omidyaghmazadeh/3D_Print_Designs/3D_Print_Platform_for_In_Vivo_MRI_in_Mice_and_Rats/Readme.md

This is an open-source versatile animal conditioning set-up for MRI (an other imaging) experiments on mice and rats. 
The design is made in a collaborative effort between the Buzsaki Lab (Neuroscience Institute), the Alon Lab (Radiology Dep.), and the Preclinical Imaging Lab (Radiology Dep.) at the NYU Langone Medical Center.

RodentMRI_bed

Parts with finer dimensions are optimized for Form 2 printer from Formlab. Adjustments might be needed for other printers.
The stand.stl and walls.stl might be printed by most printers without issue.

The complete and easy-to-modify design (developed using Autodesk Fusion 360) is available at: https://a360.co/3u0Dsnh. 

For any questions or concerns please contact omid.yaghmazadeh@gmail.com

The headfixation mechanism was modified based on Mihaly Voroslakos' design available at:
https://github.com/misiVoroslakos/3D_printed_designs/tree/main/mouse_treadmill_RF.

This design is distributed under the GNU GPLv3 license.

--> If you use our design, please cite our paper:
Ben Youss, Z., Arefin, T.M., et al. Open-source versatile 3D-print animal conditioning platform design for in vivo preclinical brain imaging in awake mice and anesthetized mice and rats. Lab Anim 53, 33–42 (2024). https://doi.org/10.1038/s41684-023-01320-z

We have also developed a cooling/heating system that is compatible with this design and open-source. If interested, please see the following paper: Verghese G, et al. Autonomous animal heating and cooling system for temperature-regulated magnetic resonance experiments. NMR in Biomedicine. 2024; 37(2):e5046. doi:10.1002/nbm.5046
