omidyaghmazadeh/3D_Print_Designs/ProbeParking/Readme.md

This is a holder with 10 spots with a similar diameter (at the central height) as the electrode holder rod of the Kopf stereotaxic system. It is the parking lot for your used silicon probes or other implants.

Holder_Station_Base v10

Design by Omid Yaghmazadeh - 2022
