omidyaghmazadeh/3D_Print_Designs/Mouse_HeadFixation_SetUp/Readme.md

This is a headfixation set-up for neuroscience experiments on mice. 
The head-cap is designed to provide a large surface on the skull for implanting probes, fibers, etc.

HeadFixed_Miniscope v9

Parts with finer dimensions are optimized for Form 2 printer from Formlab. Adjustment might be needed for other printers.
The stand.stl and walls.stl might be printed by most printers without issue.

This headfixation system was modified based on Mihaly Voroslakos' design available at:
https://github.com/misiVoroslakos/3D_printed_designs/tree/main/mouse_treadmill_RF.

This design is distributed under GNU GPLv3 license.
