omidyaghmazadeh/3D_Print_Designs/3D_Print_Platform_for_In_Vivo_MRI_in_Mice_and_Rats/Base_Joint1.stl

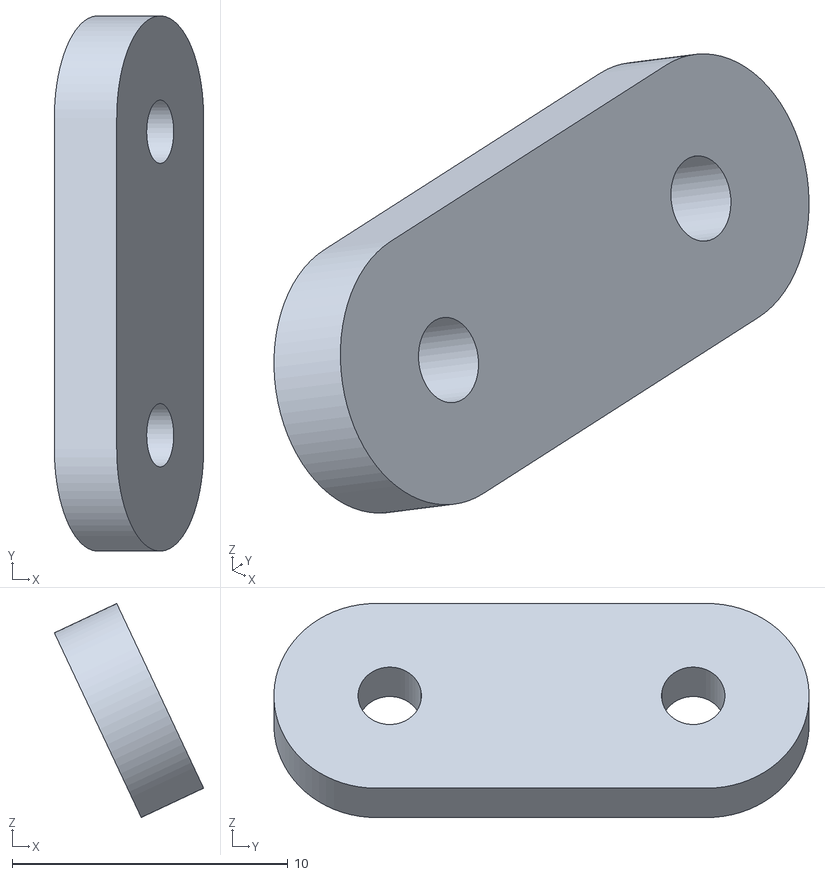
[picture p1: CAD file, 2022-05-18]
3D_Print_Platform_for_In_Vivo_MRI_in_Mice_and_Rats/Base_Joint1.stl
5.41 x 19.4 x 7.76
