omidyaghmazadeh/3D_Print_Designs/Mouse_HeadFixation_SetUp/StandHolder1.stl

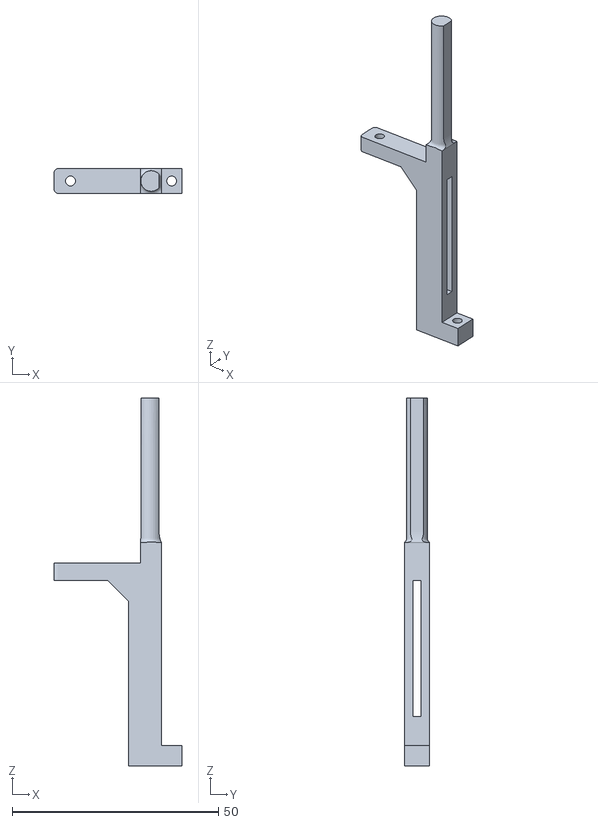
[picture p2: CAD file, 2022-04-08]
Mouse_HeadFixation_SetUp/StandHolder1.stl
31.0 x 6.04 x 89.2
