omidyaghmazadeh/3D_Print_Designs/ProbeParking/BaseFor10ProbeHolders_NarrowerTop.stl

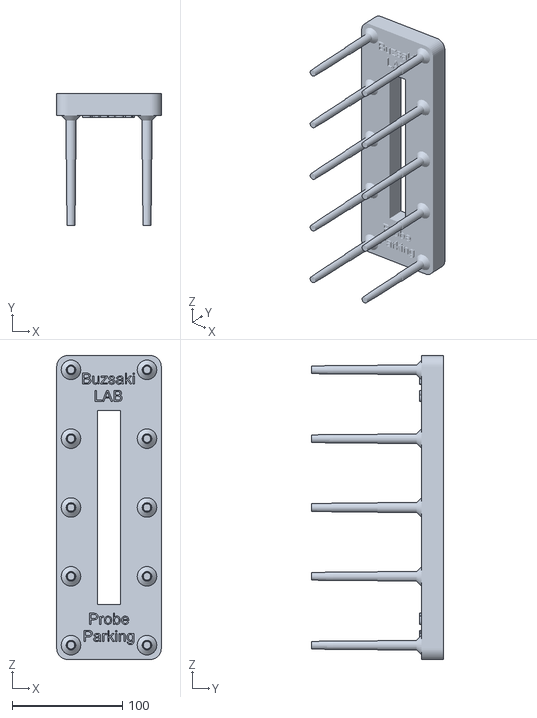
[picture p3: CAD file, 2022-10-27]
ProbeParking/BaseFor10ProbeHolders_NarrowerTop.stl
95.0 x 120.0 x 276.0
