omidyaghmazadeh/3D_Print_Designs/3D_Print_Platform_for_In_Vivo_MRI_in_Mice_and_Rats/HeadFixClamp2.stl

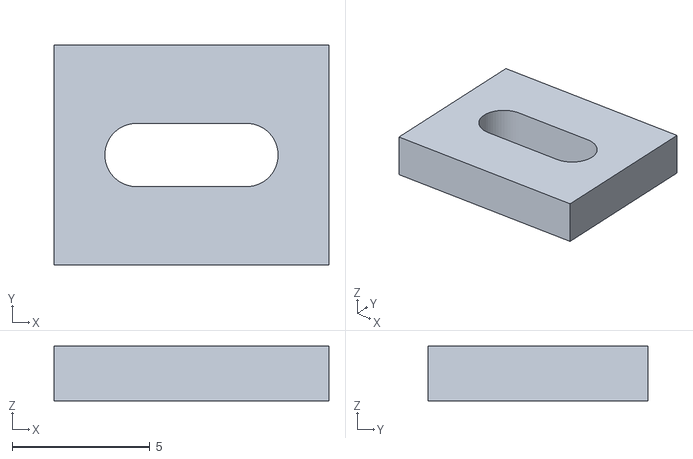
[picture p4: CAD file, 2022-05-18]
3D_Print_Platform_for_In_Vivo_MRI_in_Mice_and_Rats/HeadFixClamp2.stl
10.0 x 8.00 x 2.00
