omidyaghmazadeh/3D_Print_Designs/Mouse_HeadFixation_SetUp/Stand.stl

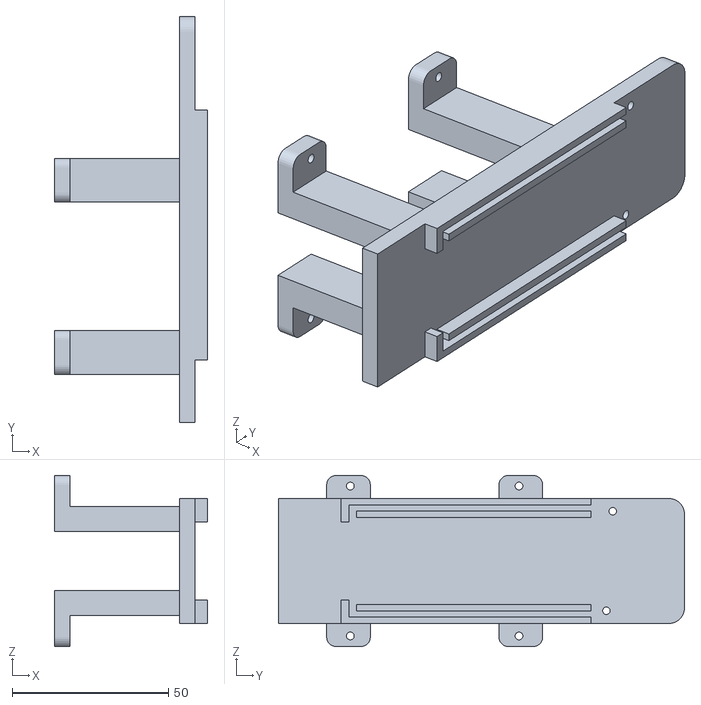
[picture p5: CAD file, 2022-04-08]
Mouse_HeadFixation_SetUp/Stand.stl
49.0 x 130.0 x 54.8
