omidyaghmazadeh/3D_Print_Designs/3D_Print_Platform_for_In_Vivo_MRI_in_Mice_and_Rats/PreampPlate.stl

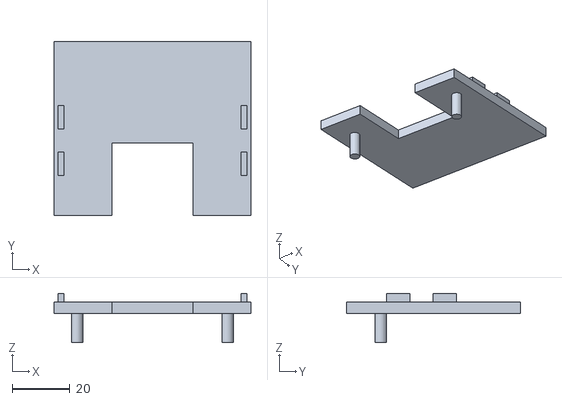
[picture p6: CAD file, 2022-05-18]
3D_Print_Platform_for_In_Vivo_MRI_in_Mice_and_Rats/PreampPlate.stl
68.0 x 60.0 x 17.0
