omidyaghmazadeh/3D_Print_Designs/3D_Print_Platform_for_In_Vivo_MRI_in_Mice_and_Rats/Mouse restrainer.stl

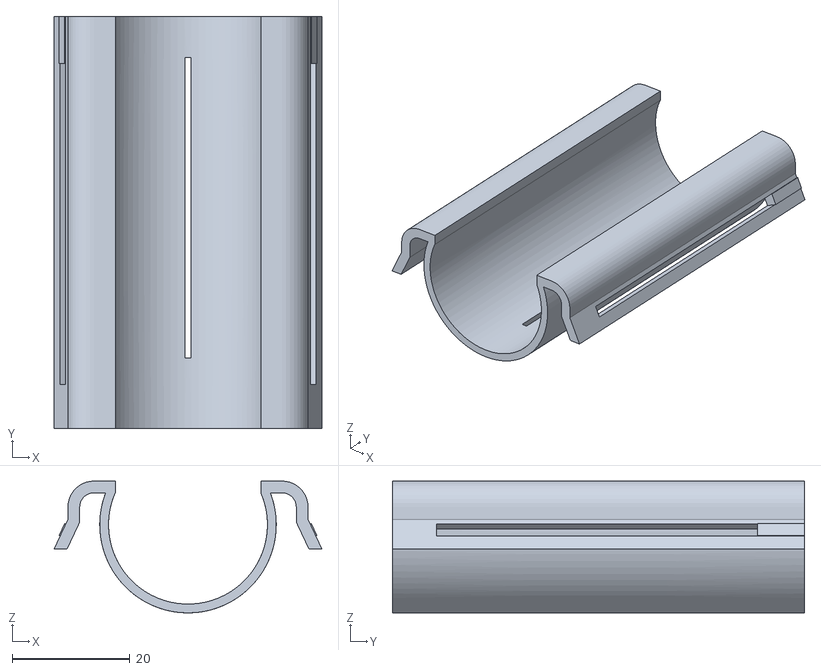
[picture p7: CAD file, 2022-05-18]
3D_Print_Platform_for_In_Vivo_MRI_in_Mice_and_Rats/Mouse restrainer.stl
45.5 x 70.0 x 22.4
