omidyaghmazadeh/3D_Print_Designs/Mouse_HeadFixation_SetUp/HeadCapHolder1.stl

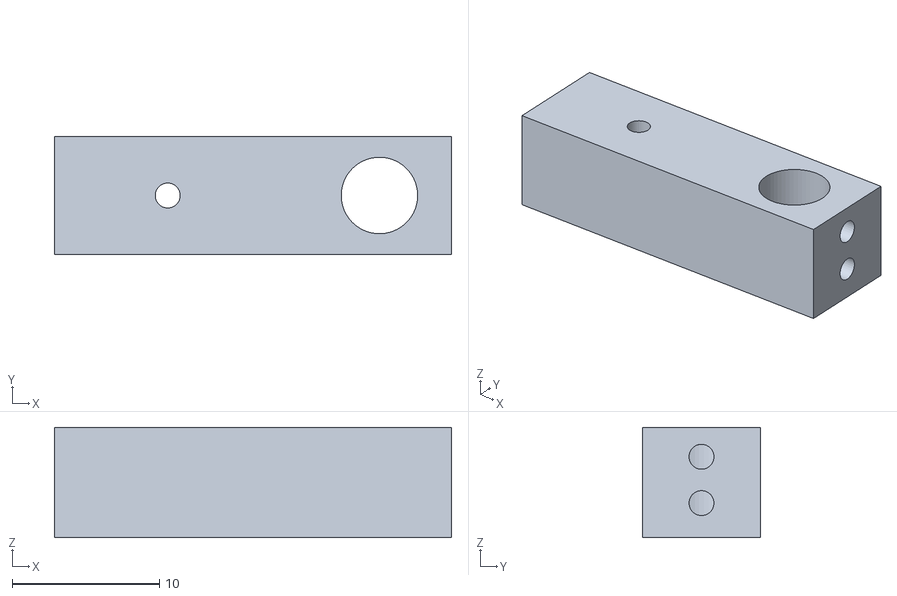
[picture p8: CAD file, 2022-04-08]
Mouse_HeadFixation_SetUp/HeadCapHolder1.stl
27.0 x 8.00 x 7.50
