omidyaghmazadeh/3D_Print_Designs/3D_Print_Platform_for_In_Vivo_MRI_in_Mice_and_Rats/StandExtention.stl

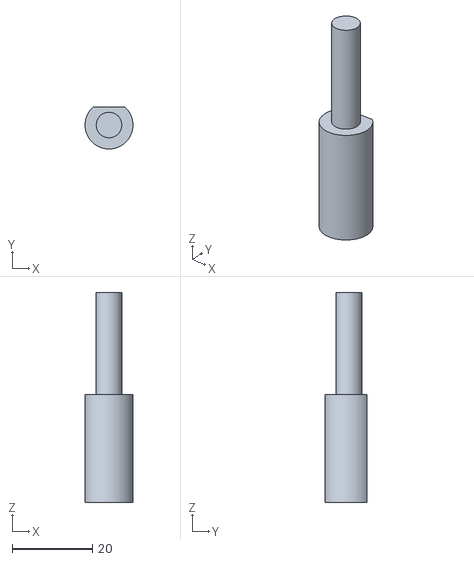
[picture p9: CAD file, 2022-05-18]
3D_Print_Platform_for_In_Vivo_MRI_in_Mice_and_Rats/StandExtention.stl
12.0 x 10.5 x 52.5
