omidyaghmazadeh/3D_Print_Designs/3D_Print_Platform_for_In_Vivo_MRI_in_Mice_and_Rats/MouseNoseCone.stl

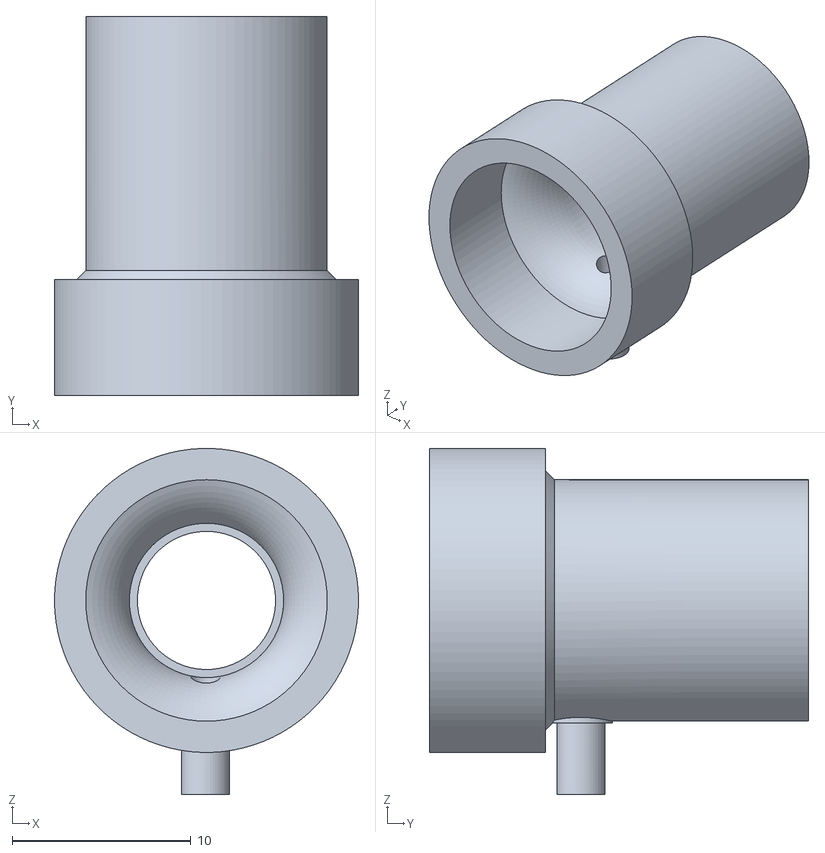
[picture p10: CAD file, 2022-05-18]
3D_Print_Platform_for_In_Vivo_MRI_in_Mice_and_Rats/MouseNoseCone.stl
17.0 x 21.2 x 19.3
