omidyaghmazadeh/3D_Print_Designs/Mouse_HeadFixation_SetUp/MouseHeadFixCapBase.stl

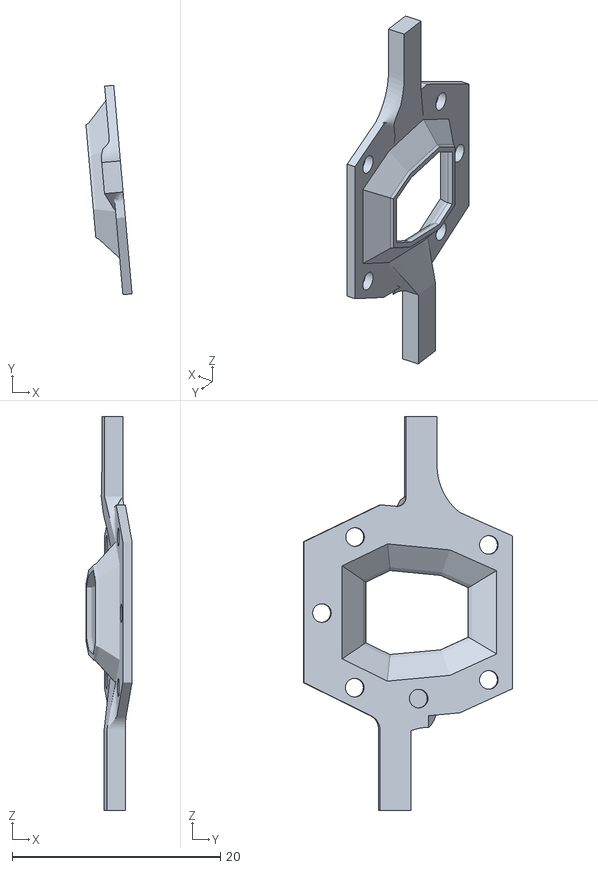
[picture p11: CAD file, 2022-04-08]
Mouse_HeadFixation_SetUp/MouseHeadFixCapBase.stl
4.43 x 20.1 x 37.9
