omidyaghmazadeh/3D_Print_Designs/3D_Print_Platform_for_In_Vivo_MRI_in_Mice_and_Rats/CableHolderArm1.stl

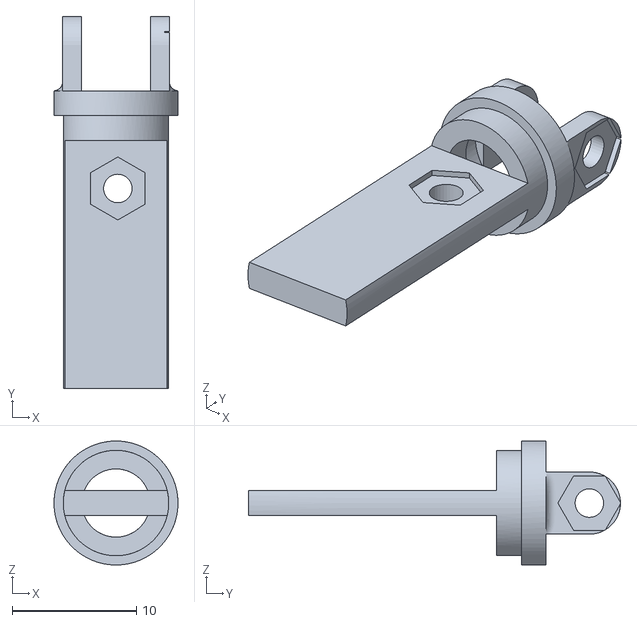
[picture p12: CAD file, 2022-05-18]
3D_Print_Platform_for_In_Vivo_MRI_in_Mice_and_Rats/CableHolderArm1.stl
10.00 x 30.0 x 9.99
