omidyaghmazadeh/3D_Print_Designs/Mouse_HeadFixation_SetUp/Walls.stl

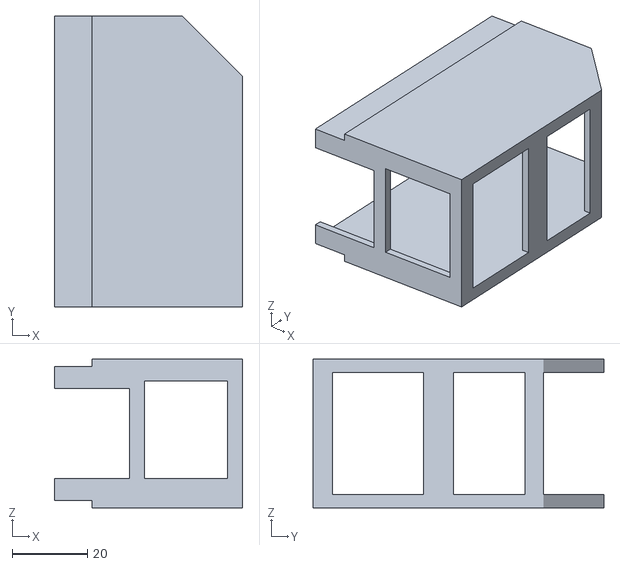
[picture p13: CAD file, 2022-04-08]
Mouse_HeadFixation_SetUp/Walls.stl
50.0 x 77.3 x 39.6
