omidyaghmazadeh/3D_Print_Designs/3D_Print_Platform_for_In_Vivo_MRI_in_Mice_and_Rats/BaseExtentionForPreAmp.stl

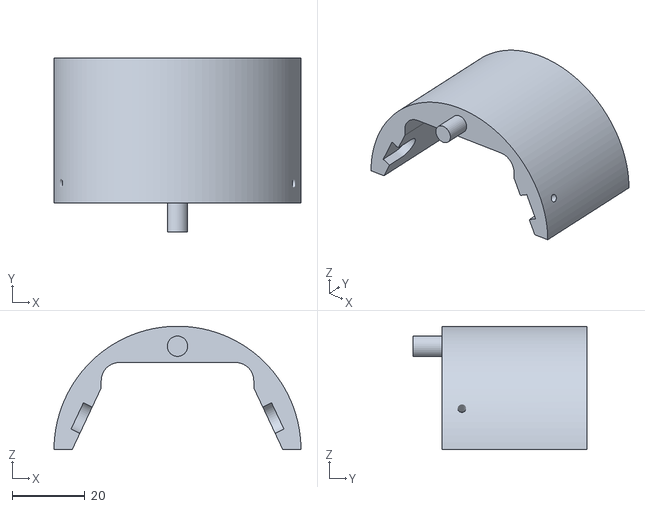
[picture p14: CAD file, 2022-05-18]
3D_Print_Platform_for_In_Vivo_MRI_in_Mice_and_Rats/BaseExtentionForPreAmp.stl
68.0 x 48.0 x 34.0
