omidyaghmazadeh/3D_Print_Designs/3D_Print_Platform_for_In_Vivo_MRI_in_Mice_and_Rats/Resterainer pusher.stl

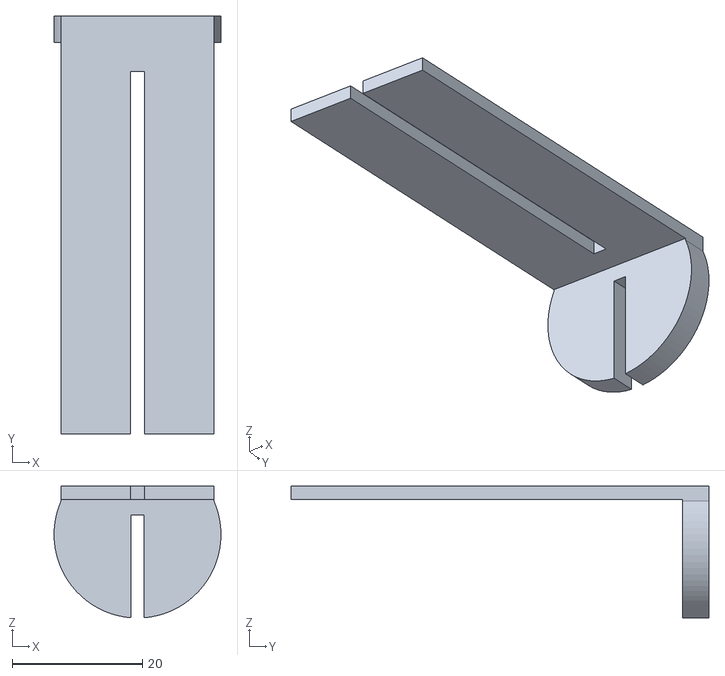
[picture p15: CAD file, 2022-05-18]
3D_Print_Platform_for_In_Vivo_MRI_in_Mice_and_Rats/Resterainer pusher.stl
25.6 x 64.0 x 20.2
