omidyaghmazadeh/3D_Print_Designs/3D_Print_Platform_for_In_Vivo_MRI_in_Mice_and_Rats/CableHolderArm3.stl

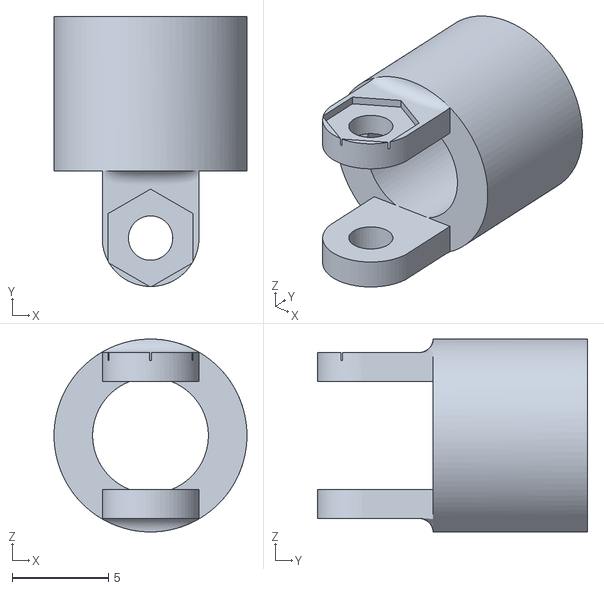
[picture p16: CAD file, 2022-05-18]
3D_Print_Platform_for_In_Vivo_MRI_in_Mice_and_Rats/CableHolderArm3.stl
10.0 x 14.0 x 10.00
