omidyaghmazadeh/3D_Print_Designs/3D_Print_Platform_for_In_Vivo_MRI_in_Mice_and_Rats/CableHolderArm2.stl

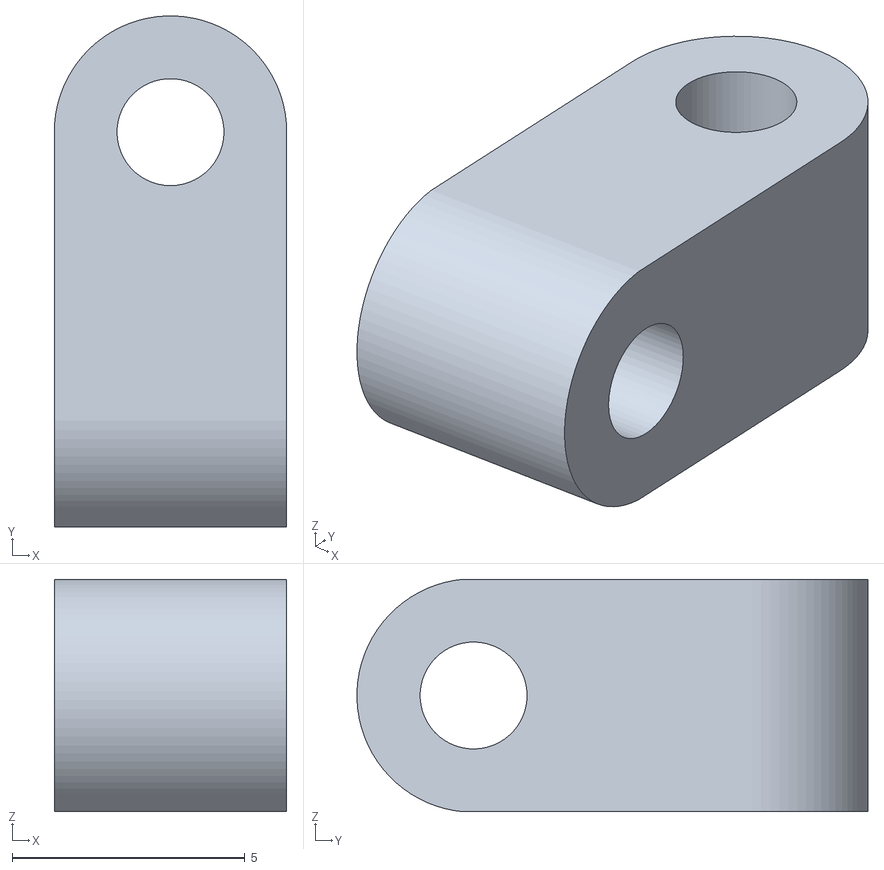
[picture p17: CAD file, 2022-05-18]
3D_Print_Platform_for_In_Vivo_MRI_in_Mice_and_Rats/CableHolderArm2.stl
5.00 x 11.0 x 5.00
