omidyaghmazadeh/3D_Print_Designs/3D_Print_Platform_for_In_Vivo_MRI_in_Mice_and_Rats/CableHolderArm4.stl

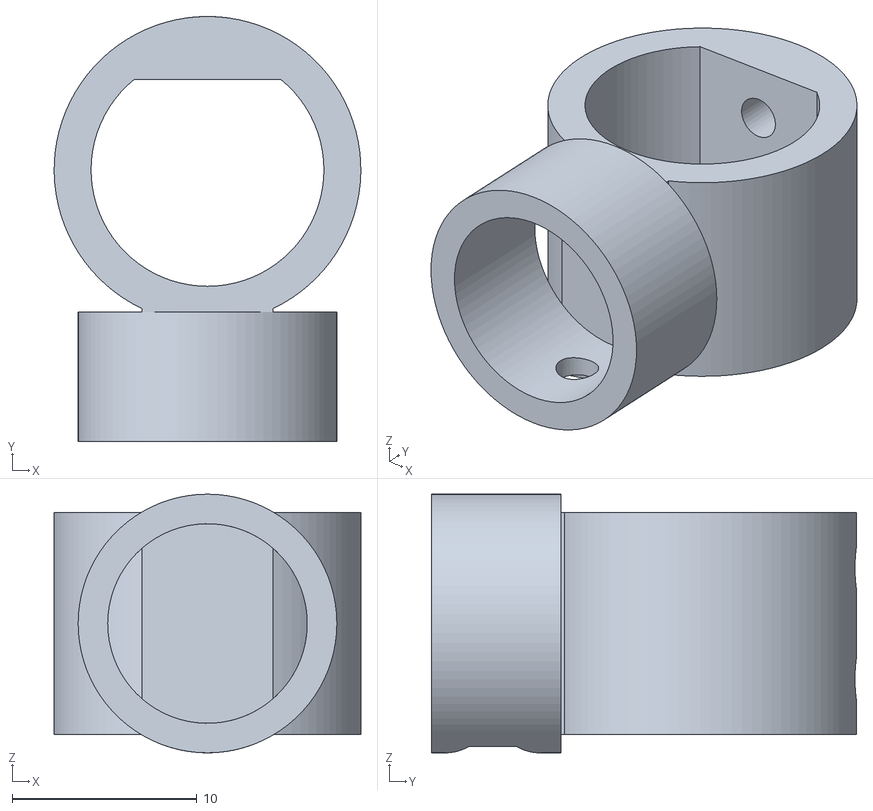
[picture p19: CAD file, 2022-05-18]
3D_Print_Platform_for_In_Vivo_MRI_in_Mice_and_Rats/CableHolderArm4.stl
16.6 x 23.0 x 14.0
