omidyaghmazadeh/3D_Print_Designs/3D_Print_Platform_for_In_Vivo_MRI_in_Mice_and_Rats/MouseHeadCapBase2.stl

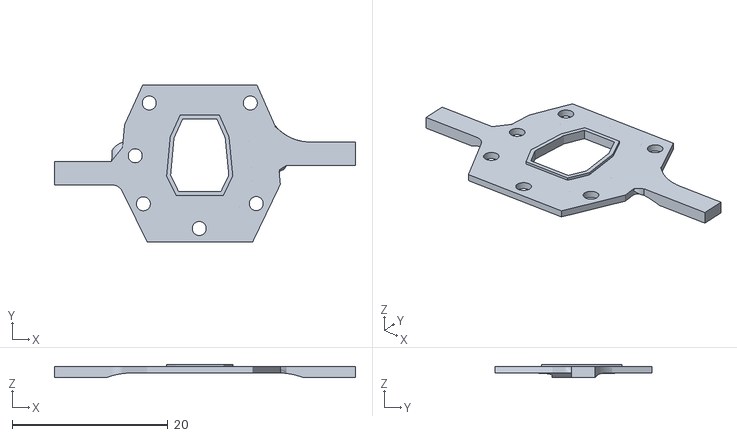
[picture p20: CAD file, 2022-05-18]
3D_Print_Platform_for_In_Vivo_MRI_in_Mice_and_Rats/MouseHeadCapBase2.stl
38.6 x 20.1 x 1.71
