omidyaghmazadeh/3D_Print_Designs/3D_Print_Platform_for_In_Vivo_MRI_in_Mice_and_Rats/MouseHeadCapBase1.stl

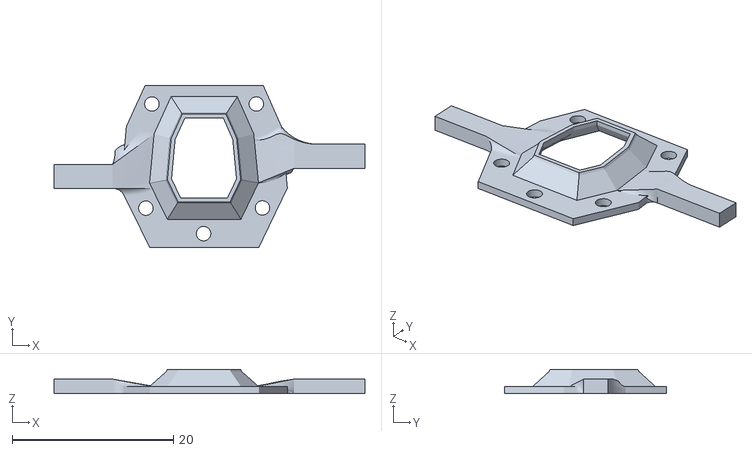
[picture p21: CAD file, 2022-05-18]
3D_Print_Platform_for_In_Vivo_MRI_in_Mice_and_Rats/MouseHeadCapBase1.stl
38.6 x 20.1 x 3.00
