omidyaghmazadeh/3D_Print_Designs/3D_Print_Platform_for_In_Vivo_MRI_in_Mice_and_Rats/HeadFixBase2.stl

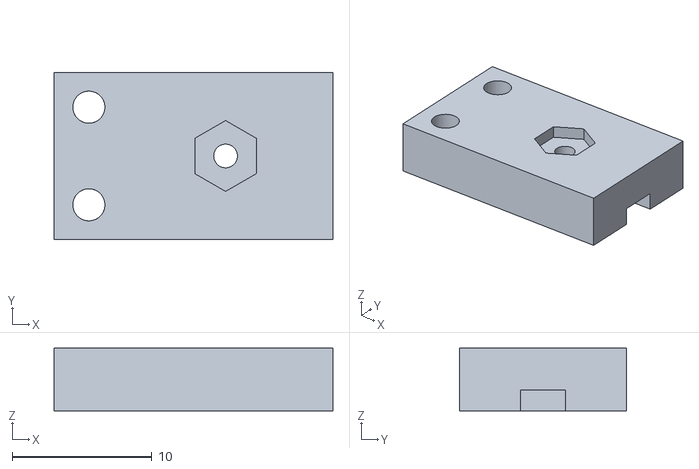
[picture p23: CAD file, 2022-05-18]
3D_Print_Platform_for_In_Vivo_MRI_in_Mice_and_Rats/HeadFixBase2.stl
20.0 x 12.0 x 4.50
