omidyaghmazadeh/3D_Print_Designs/3D_Print_Platform_for_In_Vivo_MRI_in_Mice_and_Rats/CableHolderClamp2.stl

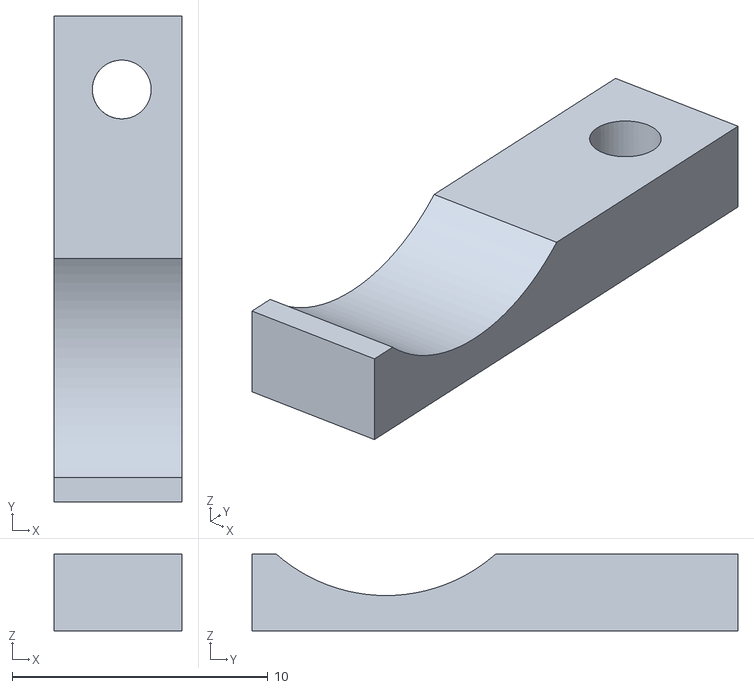
[picture p25: CAD file, 2022-05-18]
3D_Print_Platform_for_In_Vivo_MRI_in_Mice_and_Rats/CableHolderClamp2.stl
5.00 x 19.0 x 3.00
