omidyaghmazadeh/3D_Print_Designs/3D_Print_Platform_for_In_Vivo_MRI_in_Mice_and_Rats/MouseEarbar1.stl

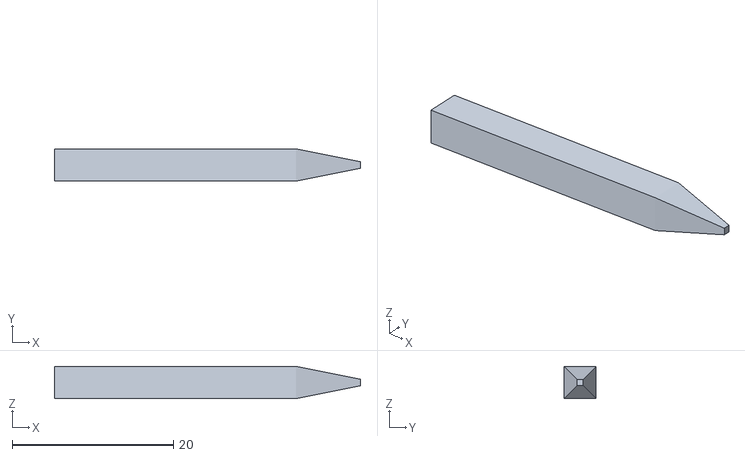
[picture p26: CAD file, 2022-05-18]
3D_Print_Platform_for_In_Vivo_MRI_in_Mice_and_Rats/MouseEarbar1.stl
38.0 x 4.00 x 4.00
