omidyaghmazadeh/3D_Print_Designs/3D_Print_Platform_for_In_Vivo_MRI_in_Mice_and_Rats/Mouse_ToothHolder.stl

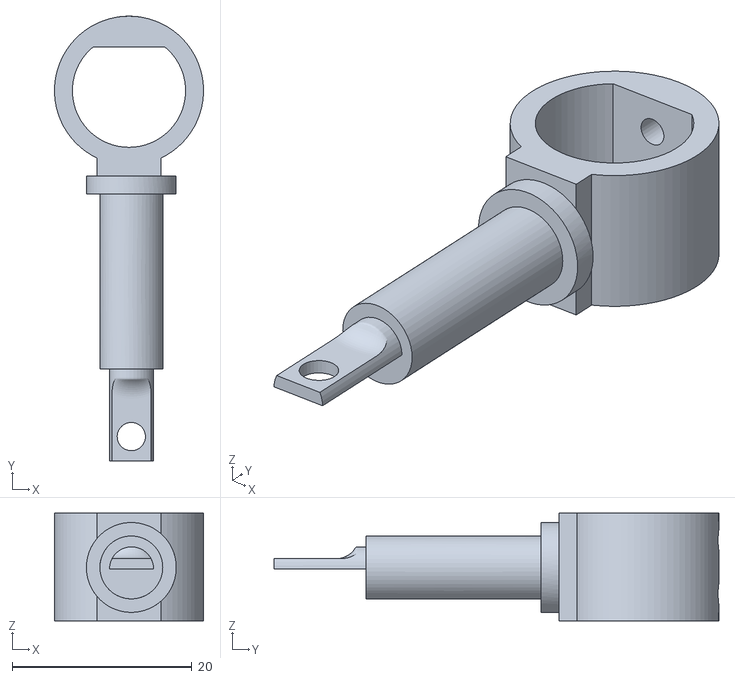
[picture p27: CAD file, 2022-05-18]
3D_Print_Platform_for_In_Vivo_MRI_in_Mice_and_Rats/Mouse_ToothHolder.stl
16.6 x 49.5 x 12.0
