omidyaghmazadeh/3D_Print_Designs/3D_Print_Platform_for_In_Vivo_MRI_in_Mice_and_Rats/Rat_ToothHolder.stl

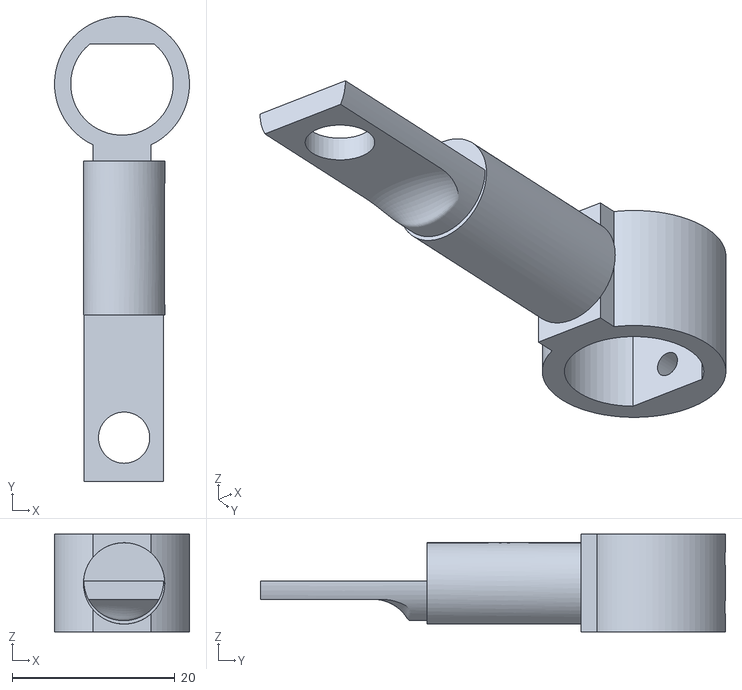
[picture p29: CAD file, 2022-05-18]
3D_Print_Platform_for_In_Vivo_MRI_in_Mice_and_Rats/Rat_ToothHolder.stl
16.6 x 57.2 x 12.0
