omidyaghmazadeh/3D_Print_Designs/(list of files, cad)

Other CAD files:
Mouse_HeadFixation_SetUp/StandHolder2.stl
Mouse_HeadFixation_SetUp/HeadCapFixer1.stl
3D_Print_Platform_for_In_Vivo_MRI_in_Mice_and_Rats/Base_Joint2.stl
Mouse_HeadFixation_SetUp/HeadCapFixer2.stl
Mouse_HeadFixation_SetUp/HeadCapHolder2.stl
3D_Print_Platform_for_In_Vivo_MRI_in_Mice_and_Rats/Base_Joint3.stl
3D_Print_Platform_for_In_Vivo_MRI_in_Mice_and_Rats/HEadFixBase1.stl
3D_Print_Platform_for_In_Vivo_MRI_in_Mice_and_Rats/RatEarbar2.stl
3D_Print_Platform_for_In_Vivo_MRI_in_Mice_and_Rats/Base_Joint4.stl
3D_Print_Platform_for_In_Vivo_MRI_in_Mice_and_Rats/MouseEarbar2.stl
3D_Print_Platform_for_In_Vivo_MRI_in_Mice_and_Rats/HeadFixClamp1.stl
