omidyaghmazadeh/3D_Print_Designs/3D_Print_Platform_for_In_Vivo_MRI_in_Mice_and_Rats/Assmebly_instructions.pdf

### Assembly Process for 3D-print rodent conditioning platform for imaging experiments according to Gironda et. al. 2023

Document prepared by: Griffin Henze March 28, 2023

Parts list:

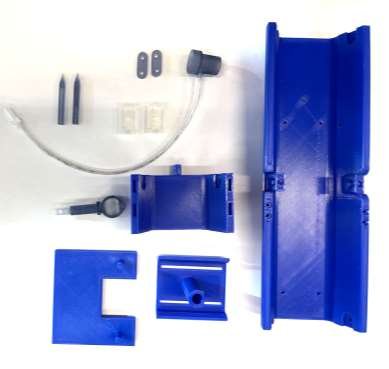
[picture p32: figure]

Name of item | Amount used/ Description | Part number
3d printed parts | As per the design | N/A
Plastic tubing | 1 x 20 cm long/ 1/8 inch inside diameter | Tygon S3 E-3603
M-2 Nylon Screw | 17x | McMaster-Carr 92929A238
M-2 Nylon Hex Nut | 17x | McMaster-Carr 93800A300
Female Luer with 1/8 in. ID Brab | 1x | FisherScientific 01000136

### 1. Preparing the base

a. Insert nuts into preformed holes and attach with glue.

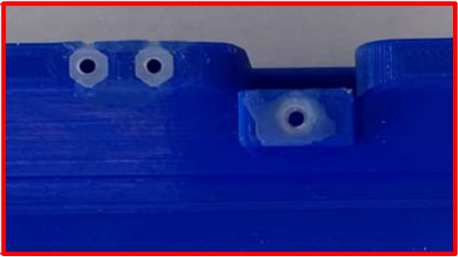
[picture p33: figure]
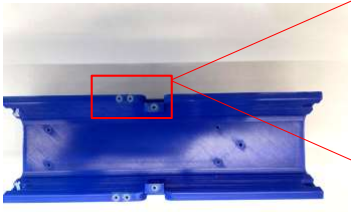
[picture p34: figure]

b. For holes on the exterior of the bed, insert screw from inside then screw on nut and glue the nut to the bed, being careful not to glue the screw in the nut.

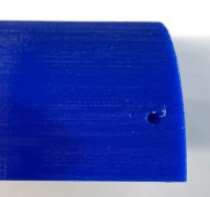
[picture p35: figure]
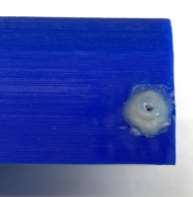
[picture p36: figure]

c. On the bottom of the bed, insert nuts into pre drilled holes and glue to bed.
d. Screw head fixation base onto the bed and insert ear bars into designated slots.

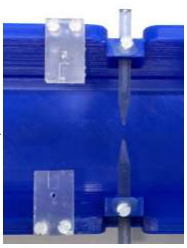
[picture p37: figure]
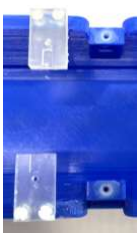
[picture p38: figure]
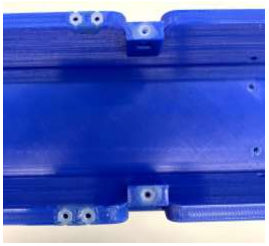
[picture p39: figure]

### 2. Nose cone assembly

a. Slide the nose cap onto one end of the tubing and glue. Slide connector onto other end and glue.

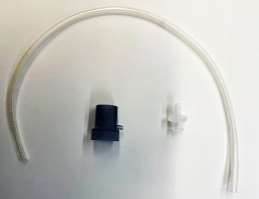
[picture p40: figure]
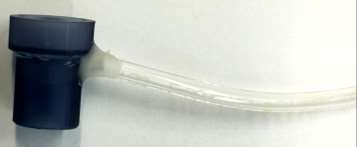
[picture p41: figure]
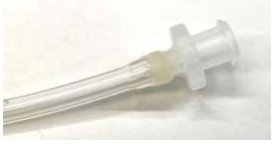
[picture p42: figure]

### 3. Sliding stand piece assembly

a. Glue nuts to the rodent tooth holder and add screws.

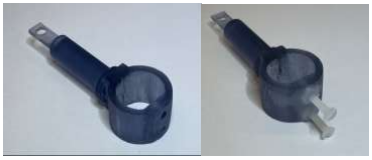
[picture p43: figure]

b. Slide the rodent tooth holder onto the post and tighten screws, then slide the nose cap over the tooth holder.

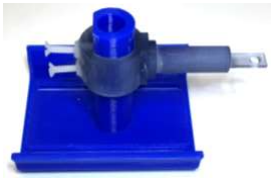
[picture p44: figure]
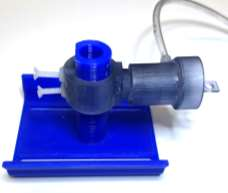
[picture p45: figure]

c. Screw the sliding nose piece into the bed. Note that the screws can be loosened and tightened to move the sled back and forth.

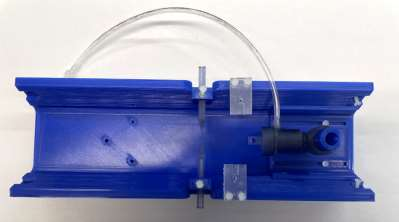
[picture p46: figure]

4. Attach connectors to each corner of the bed.

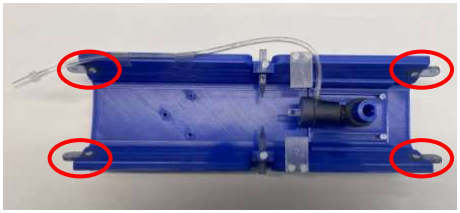
[picture p47: figure]

### 5. Extender (preamplifier holder) assembly

a. Insert screw, and screw on nut. Glue nut to exterior being careful not to glue screw to nut.

=

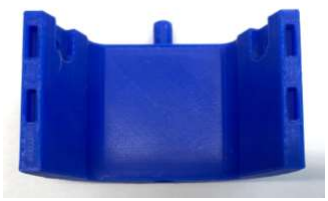
[picture p48: figure]
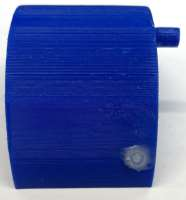
[picture p49: figure]

b. Attach bed extender to bed

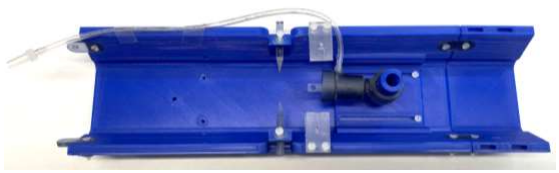
[picture p50: figure]

c. Clip the cover into place.

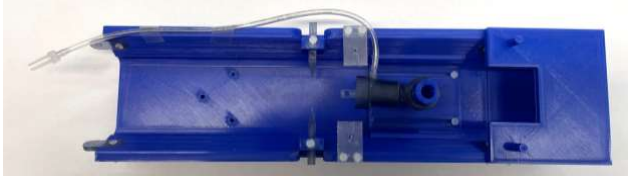
[picture p51: figure]

### 6. Rat Adaptation

To prepare the platform for use with rats, follow the same procedure as above using ratspecific parts, i.e. the rat tooth holder, nose cone and ear bars. It is recommended to prepare and use separate set-ups for mice and rats.

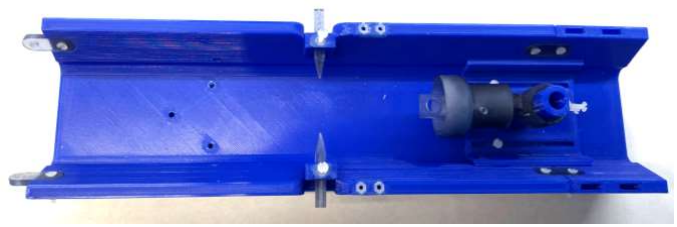
[picture p52: figure]

References:
Gironda, et al., “Open-source versatile 3D-print animal conditioning platform design for invivo preclinical brain imaging in awake mice and anesthetized mice and rats”, bioRxiv 2022.11.20.517296 (2022); doi: https://doi.org/10.1101/2022.11.20.517296 (https://urldefense.proofpoint.com/v2/url?u=https-3A__doi.org_10.1101_2022.11.20.517296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)
