omidyaghmazadeh/3D_Print_Designs/(commit log)

2022-08-20 Rename 3D Print Platform for In Vivo MRI in Mice and Rats/Readme.md to 3D_Print_Platform_for_InVivo_MRI_in_Mice_and_Rats/Readme.md
2022-08-20 Rename 3D_Print_Platform_for_InVivo_MRI_in_Mice_and_Rats/Readme.md to 3D Print Platform for In Vivo MRI in Mice and Rats/Readme.md
